Project-in-a-Box-JSOE/robotic_arm_arduino_uno_shield/Pot Holder/part#8Dimension.JPG

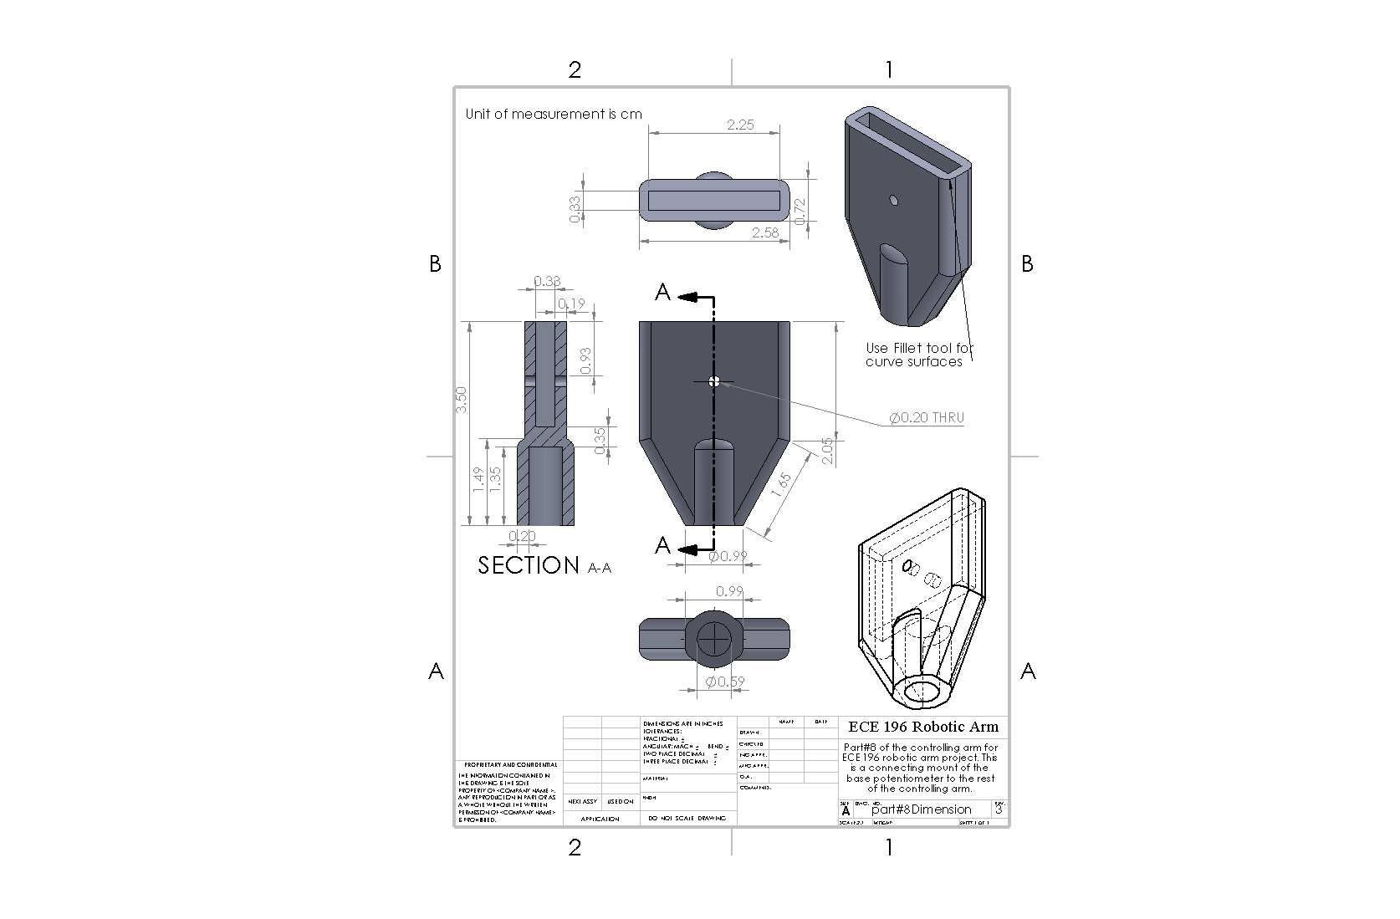
Pot Holder/part#8Dimension.JPG
