Project-in-a-Box-JSOE/robotic_arm_arduino_uno_shield/Robotic Arm PCB shield/robotic_arm_arduino_uno_shield_ece196_partList_new.csv

Qty | Value | Device | Package | Parts | Description | DATASHEET | DATASHEET_CABLE | DATASHEET_CONNECTOR | DIST | DISTLINK | DISTLINK_CABLE | DISTLINK_CONNECTOR | DISTLINK_CONNECTOR1 | DISTLINK_CONNECTOR2 | DISTPN | DISTPN_CABLE | DISTPN_CONNECTOR | DISTPN_CONNECTOR1 | DISTPN_CONNECTOR2 | DIST_CABLE | DIST_CONNECTOR | MFR | MFR_CABLE | MFR_CONNECTOR | MPN | MPN_CABLE | MPN_CONNECTOR | MPN_CONNECTOR1 | MPN_CONNECTOR2 | QTY_CONNECTOR1 | QTY_CONNECTOR2 | VALUE
4 | 0.1uF/35V | 0.1UF_SMD-0805_35V-10% | CAPC2012X95_SMD-0805 | C1, C2, C3, C4 |  | http://ds.yuden.co.jp/TYCOMPAS/ut/detail.do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 |  |  | Digikey | https://www.digikey.com/products/en?keywords=587-3364-1-ND |  |  |  |  | 587-3364-1-ND |  |  |  |  |  |  | Taiyo Yuden |  |  | GMK212BJ104KGHT |  |  |  |  |  |  | 0.1uF/35V
3 | 1000uF/16V | 1000UF-POLARIZED_PTH_16V-20% | _AE_PTH_DIA8-LS3.5-H21.50 | C0, C5, C6 |  | http://www.chemi-con.co.jp/cgi-bin/CAT_DB/SEARCH/cat_db_al.cgi?e=e&j=p&pdfname=kzm |  |  | Digikey | https://www.digikey.com/products/en?keywords=565-3567-ND |  |  |  |  | 565-3567-ND |  |  |  |  |  |  | United Chemi-Con |  |  | EKZM160ELL102MH20D |  |  |  |  |  |  | 1000uF/16V
3 | 10K | 10KΩ_SMD-0805_1/8W-5% | RESC2012X60_SMD-0805 | R0, R1, R2 |  | http://www.yageo.com/documents/recent/PYu-RC_Group_51_RoHS_L_9.pdf |  |  | Digikey | https://www.digikey.com/products/en?keywords=311-10KARCT-ND |  |  |  |  | 311-10KARCT-ND |  |  |  |  |  |  | Yageo |  |  | RC0805JR-0710KL |  |  |  |  |  |  | 10K
4 | 10K | POTENTIOMETER_CONNECTOR_PTH_VERT_FEMALE_2.54MM | HDRVR3W64P254_1X3_812X254X850B | POT1, POT2, POT3, POT4 |  | http://www.ttelectronics.com/sites/default/files/download-files/Datasheet_RotaryPanelPot_P160series.pdf |  | https://drawings-pdf.s3.amazonaws.com/10492.pdf | Digikey | https://www.digikey.com/products/en?keywords=987-1715-ND |  | https://www.digikey.com/products/en?keywords=PPTC031LFBN-RC |  |  | 987-1715-ND |  | S7001-ND |  |  |  | Digikey | TT Electronics/BI |  | Sullins Connector Solutions | P160KN2-0QA25B10K |  | PPTC031LFBN-RC |  |  |  |  | 10K
2 | 1A/50V | DIODE_GENERAL-PURPOSE_SMD_GP_1A-50V | SODFL3516X170 | D4, D5 |  | http://www.comchiptech.com/cms/UserFiles/CGRKM4001-HF%20Thru.%20CGRKM4007-HF%20RevG.pdf |  |  | Digikey | https://www.digikey.com/products/en?keywords=641-1511-1-ND |  |  |  |  | 641-1511-1-ND |  |  |  |  |  |  | Comchip Technology |  |  | CGRKM4001-HF |  |  |  |  |  |  | 1A/50V
2 | 1K | 1KΩ_SMD-0805_1/8W-5% | RESC2012X60_SMD-0805 | R3, R4 |  | http://www.yageo.com/documents/recent/PYu-RC_Group_51_RoHS_L_9.pdf |  |  | Digikey | https://www.digikey.com/products/en?keywords=311-1.0KARCT-ND |  |  |  |  | 311-1.0KARCT-ND |  |  |  |  |  |  | Yageo |  |  | RC0805JR-071KL |  |  |  |  |  |  | 1K
2 | 50mA/12V | SWITCH_MOMENTARY_SPST_PTH_L12-W12-H7.2 | BTN_MOMENTARY_SPST-NO_PTH_L12-W12 | S2, S3 |  | https://www.sparkfun.com/datasheets/Components/Buttons/TSA12110%20TACT%20SWITCH.jpg |  |  | Digikey | https://www.digikey.com/products/en?keywords=1568-1332-ND |  |  |  |  | 1568-1332-ND |  |  |  |  |  |  | SparkFun Electronics |  |  | COM-10302 |  |  |  |  |  |  | 50mA/12V
1 | 5A/28V | POWER_JACK-BARREL_ID2.1MM-OD5.5MM_PTH_ID2.1MM-OD5.5MM | POWER_JACK_PTH_ID2.1MM-OD5.5MM | J1 |  | https://www.cui.com/product/resource/pj-102a.pdf |  |  | Digikey | https://www.digikey.com/products/en?keywords=CP-102A-ND |  |  |  |  | CP-102A-ND |  |  |  |  |  |  | CUI Inc. |  |  | PJ-102A |  |  |  |  |  |  | 5A/28V
1 | 5A/28V | SWITCH_SPDT_VERT_PTH_5A-28V_13L-7W_ | SW_TOGGLE_SPDT_5A-28V_13L-7W | S1 |  | http://spec_sheets.e-switch.com/specs/T111597.pdf |  |  | Digikey | https://www.digikey.com/products/en?keywords=EG2355-ND |  |  |  |  | EG2355-ND |  |  |  |  |  |  | E-Switch |  |  | 100SP1T1B4M2QE |  |  |  |  |  |  | 5A/28V
1 | Arduino UNO R3 | ARDUINO_UNO_R3_NO-HOLES_NO-AVR-ISP_NO-I2C_NO-NC_NO-IOREF | ARDUINO_UNO_R3_NO-HOLES_NO-AVR-ISP_NO-I2C_NO-NC_NO-IOREF | ARDUINO1 |  | https://media.digikey.com/pdf/Data%20Sheets/Arduino%20PDFs/A000066_Web.pdf | http://www.assmann-wsw.com/fileadmin/datasheets/ASS_7066_CA.pdf | http://www.sullinscorp.com/drawings/77____C___S___N-OMIT,_M500,_STRAIGHT,_C10436.pdf | Digikey | https://www.digikey.com/products/en?keywords=1050-1024-ND | https://www.digikey.com/products/en?keywords=AE1462-ND |  | https://www.digikey.com/products/en?keywords=S1012E-06-ND | https://www.digikey.com/products/en?keywords=PEC08SAAN | 1050-1024-ND | AE1462-ND |  | S1012E-06-ND | S1012E-08-ND | Digikey | Digikey | Arduino | Assmann WSW Components | Sullins Connector Solutions | A000066 | AK672/2-1 |  | PEC06SAAN | PEC08SAAN | 2 | 2 | Arduino UNO R3
1 | BATTERY_LIPO_2S | BATTERY_LIPO_2S | DUAL_PTH_PADS | LIPO1
1 | BLUE | LED_SMD-0805_DISCRETE_BLUE | LEDC2012X120_LED-0805 | PWR_LED |  | http://optoelectronics.liteon.com/upload/download/DS-22-99-0226/LTST-C170TBKT.pdf |  |  | Digikey | https://www.digikey.com/products/en?keywords=160-1579-1-ND |  |  |  |  | 160-1579-1-ND |  |  |  |  |  |  | Lite-On Inc. |  |  | LTST-C170TBKT |  |  |  |  |  |  | BLUE
1 | GREEN | LED_SMD-0805_DISCRETE_GREEN | LEDC2012X120_LED-0805 | PLAY_LED |  | http://optoelectronics.liteon.com/upload/download/DS22-2000-073/LTST-C170KGKT.pdf |  |  | Digikey | https://www.digikey.com/products/en?keywords=160-1414-1-ND |  |  |  |  | 160-1414-1-ND |  |  |  |  |  |  | Lite-On Inc. |  |  | LTST-C170KGKT |  |  |  |  |  |  | GREEN
4 | MG90S | SERVO_MG90S_PTH_VERT_FEMALE_2.54MM | HDRVR3W64P254_1X3_812X254X850B | SERVO1, SERVO2, SERVO3, SERVO4 |  | N/A |  | https://drawings-pdf.s3.amazonaws.com/10492.pdf | Amazon | https://www.amazon.com/RioRand-MG90S-Metal-Geared-Helicopter/dp/B00M8SR0ZK?s=toys-and-games |  | https://www.digikey.com/products/en?keywords=PPTC031LFBN-RC |  |  | B00M8SR0ZK |  | S7001-ND |  |  |  | Digikey | TowerPro |  | Sullins Connector Solutions | MG90S |  | PPTC031LFBN-RC |  |  |  |  | MG90S
2 | MIC39100-5.0 5V/1A | MIC39100-XX_MIC39100-5.0_1A | SOT229P700X180-4 | VREG1, VREG2 |  | http://ww1.microchip.com/downloads/en/DeviceDoc/20005834A.pdf |  |  | Digikey | https://www.digikey.com/products/en?keywords=576-1173-ND |  |  |  |  | 576-1173-ND |  |  |  |  |  |  | Microchip Technology |  |  | MIC39100-5.0WS |  |  |  |  |  |  | MIC39100-5.0 5V/1A
1 | NET_BRIDGE | NET_BRIDGE | NET_BRIDGE | SUPPLY14
1 | RED | LED_SMD-0805_DISCRETE_RED | LEDC2012X120_LED-0805 | REC_LED |  | http://optoelectronics.liteon.com/upload/download/DS-22-99-0150/LTST-C170KRKT.pdf |  |  | Digikey | https://www.digikey.com/products/en?keywords=160-1415-1-ND |  |  |  |  | 160-1415-1-ND |  |  |  |  |  |  | Lite-On Inc. |  |  | LTST-C170KRKT |  |  |  |  |  |  | RED
