Project-in-a-Box-JSOE/robotic_arm_arduino_uno_shield/BaseServoMount/BaseServoMountAssem1.SLDASM

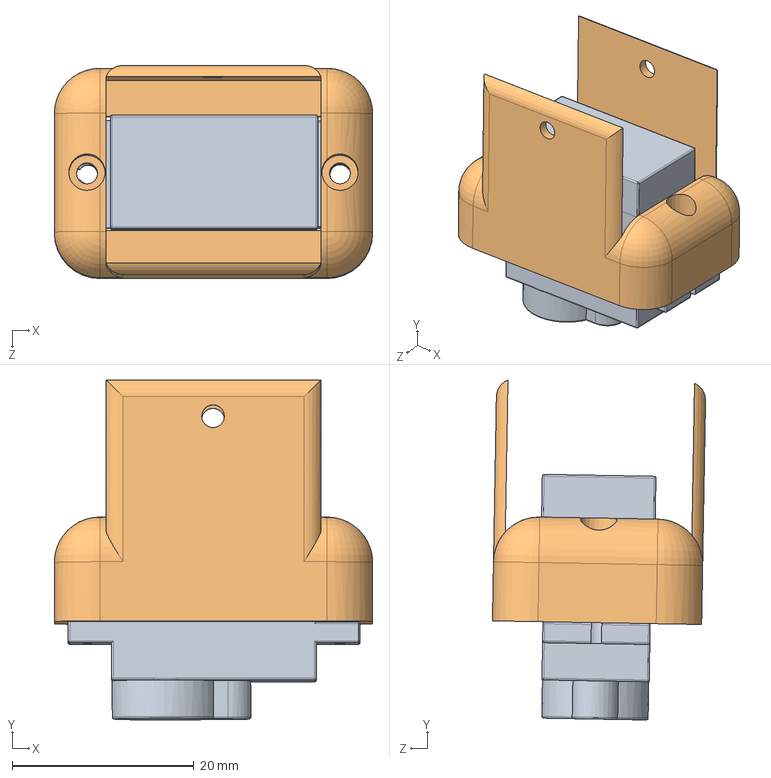
[picture p11: CAD file, 2018-07-06]
BaseServoMount/BaseServoMountAssem1.SLDASM
35.0 x 37.4 x 23.4 mm
BaseServoMount
