Project-in-a-Box-JSOE/robotic_arm_arduino_uno_shield/RoboticGripperV4/GripperAssemV1.SLDASM

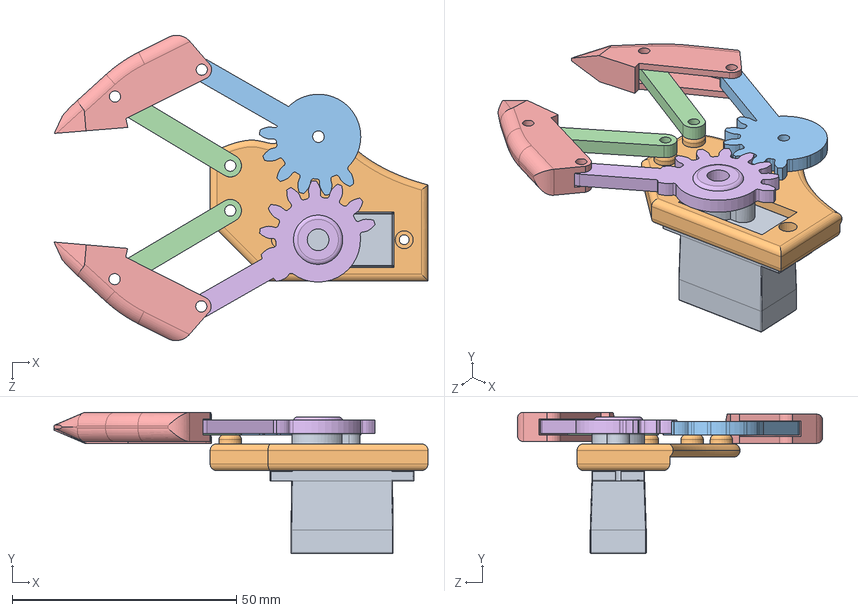
[picture p12: CAD file, 2018-07-06]
RoboticGripperV4/GripperAssemV1.SLDASM
83.4 x 31.5 x 68.1 mm
BaseV4Part1
RightGearPart2
ShortHandPart4 x 2
GripperHeadV4Part5 x 2
ServoGearPart3
