Project-in-a-Box-JSOE/robotic_arm_arduino_uno_shield/BaseServoMount/BaseServoMount.SLDPRT

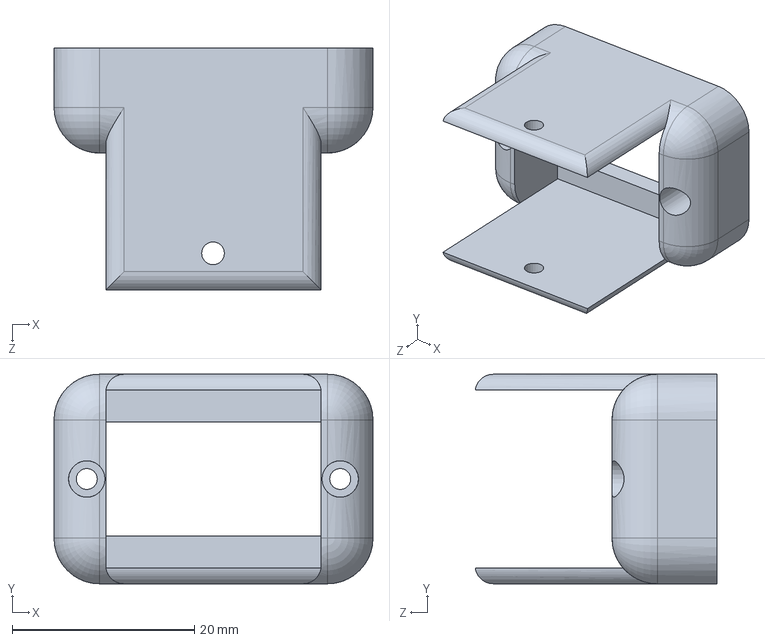
[picture p13: CAD file, 2018-07-06]
BaseServoMount/BaseServoMount.SLDPRT
35.0 x 23.0 x 26.5 mm
