Project-in-a-Box-JSOE/robotic_arm_arduino_uno_shield/Pot Holder/potHolderV5.STL

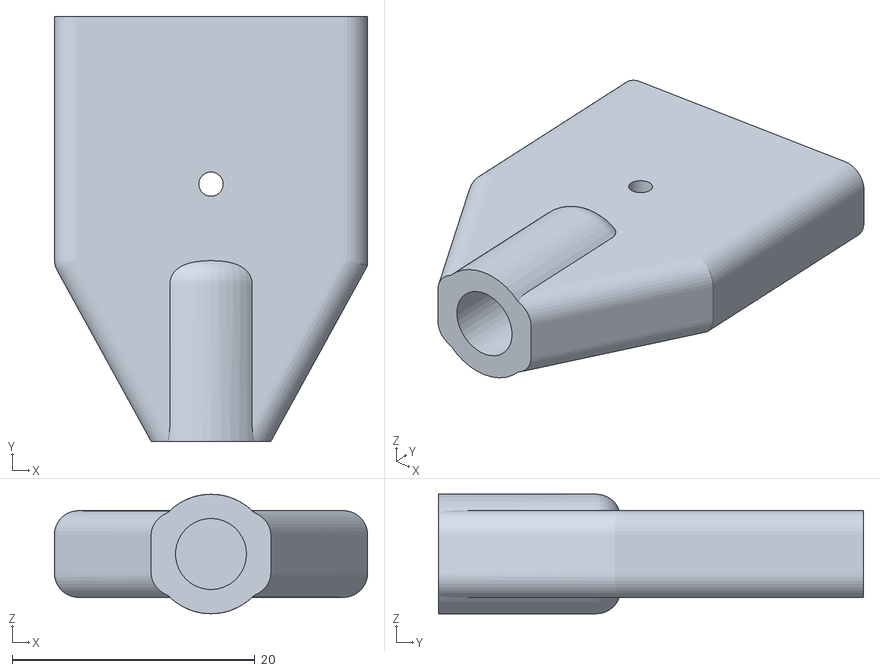
[picture p14: CAD file, 2018-07-06]
Pot Holder/potHolderV5.STL
25.8 x 35.0 x 9.85
