Project-in-a-Box-JSOE/robotic_arm_arduino_uno_shield/RoboticGripperV4/GripperHeadV4Part5.SLDPRT

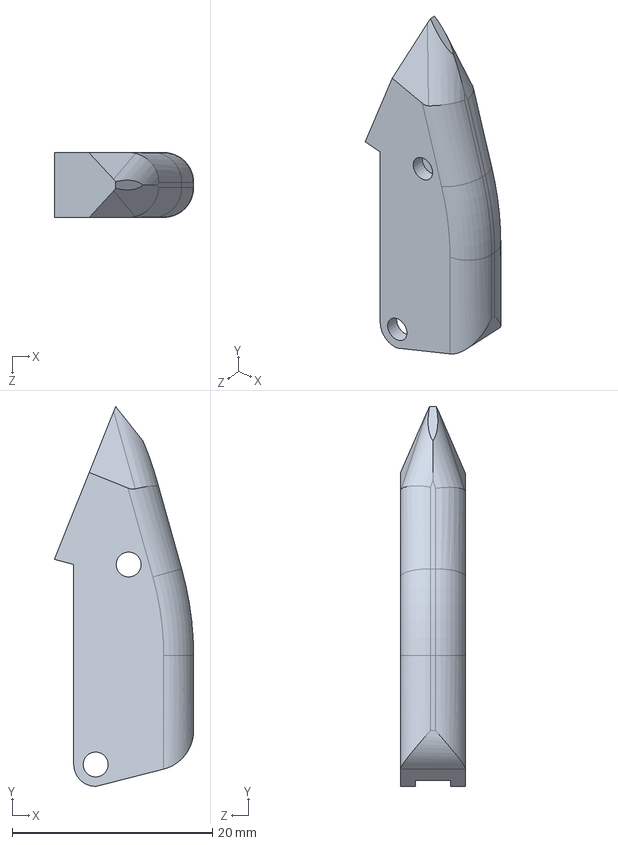
[picture p15: CAD file, 2018-07-06]
RoboticGripperV4/GripperHeadV4Part5.SLDPRT
13.9 x 38.0 x 6.50 mm
