Project-in-a-Box-JSOE/robotic_arm_arduino_uno_shield/RoboticGripperV4/ShortHandPart4.SLDPRT

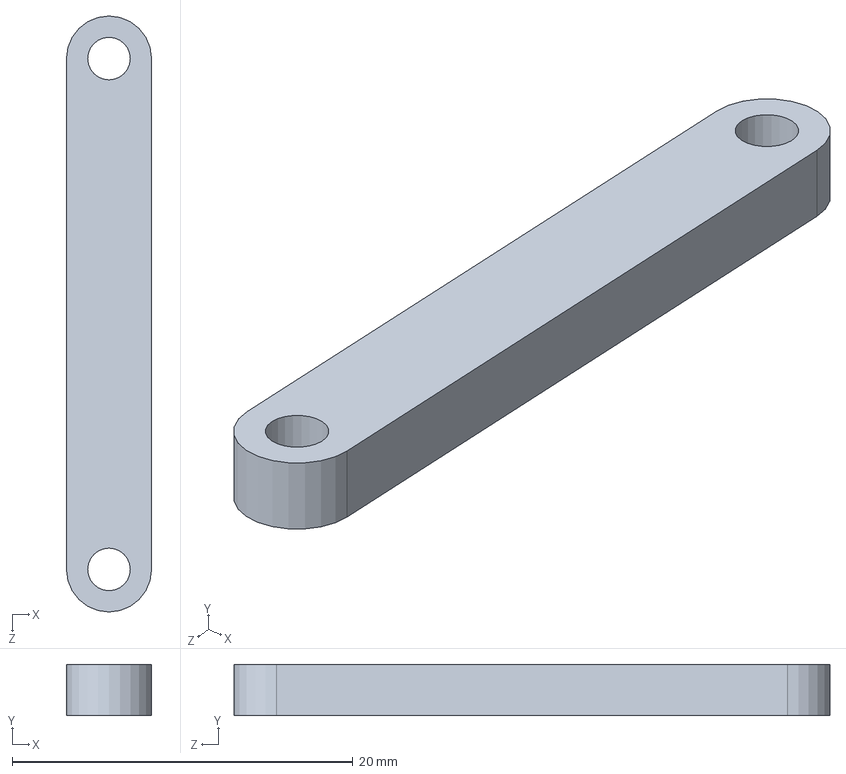
[picture p16: CAD file, 2018-07-06]
RoboticGripperV4/ShortHandPart4.SLDPRT
5.00 x 3.00 x 35.0 mm
