Project-in-a-Box-JSOE/robotic_arm_arduino_uno_shield/RoboticGripperV4/Part1.SLDPRT

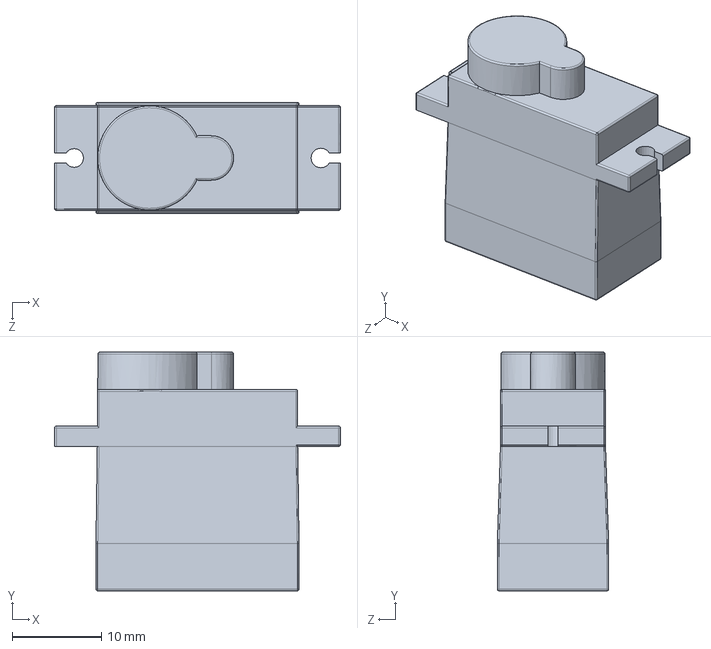
[picture p17: CAD file, 2018-07-06]
RoboticGripperV4/Part1.SLDPRT
32.1 x 26.8 x 12.5 mm
