Project-in-a-Box-JSOE/robotic_arm_arduino_uno_shield/RoboticGripperV4/BaseV4Part1.SLDPRT

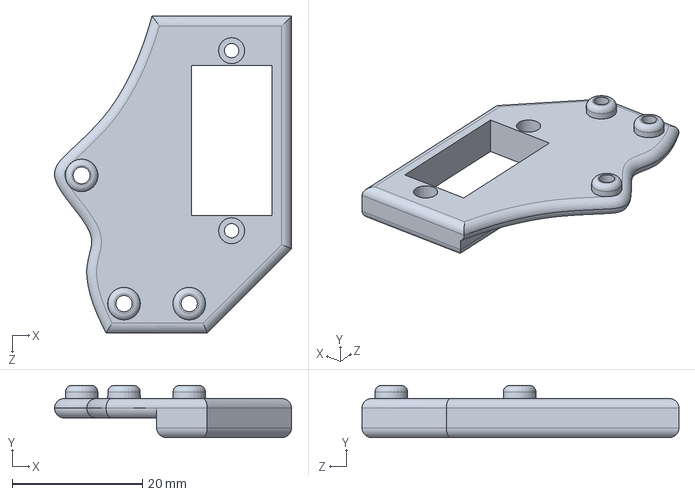
[picture p18: CAD file, 2018-07-06]
RoboticGripperV4/BaseV4Part1.SLDPRT
36.3 x 8.00 x 48.6 mm
