Project-in-a-Box-JSOE/robotic_arm_arduino_uno_shield/RoboticGripperV4/RightGearPart2.SLDPRT

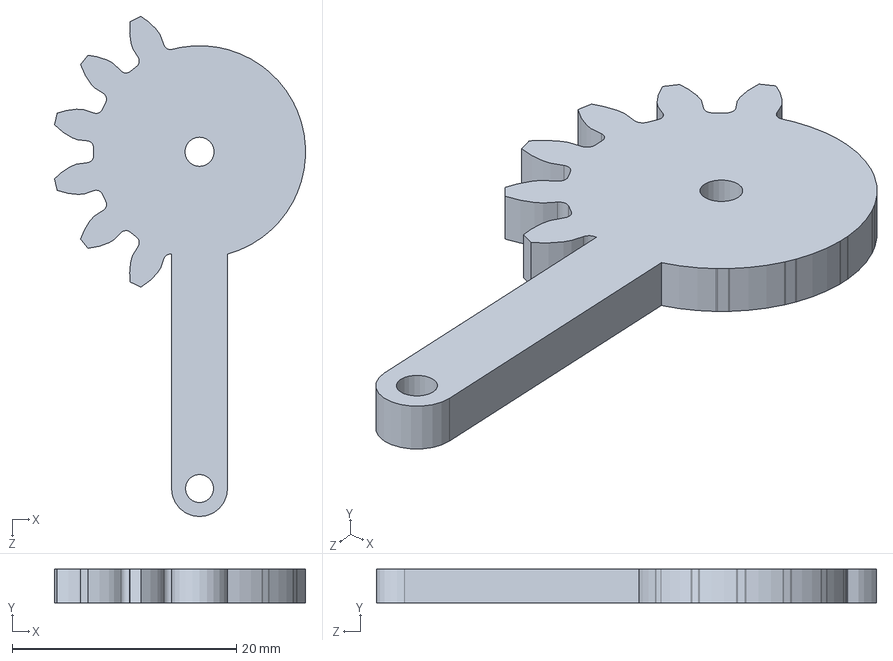
[picture p19: CAD file, 2018-07-06]
RoboticGripperV4/RightGearPart2.SLDPRT
22.4 x 3.00 x 44.6 mm
