Project-in-a-Box-JSOE/robotic_arm_arduino_uno_shield/RoboticGripperV4/GripperHeadV5Part5.SLDPRT

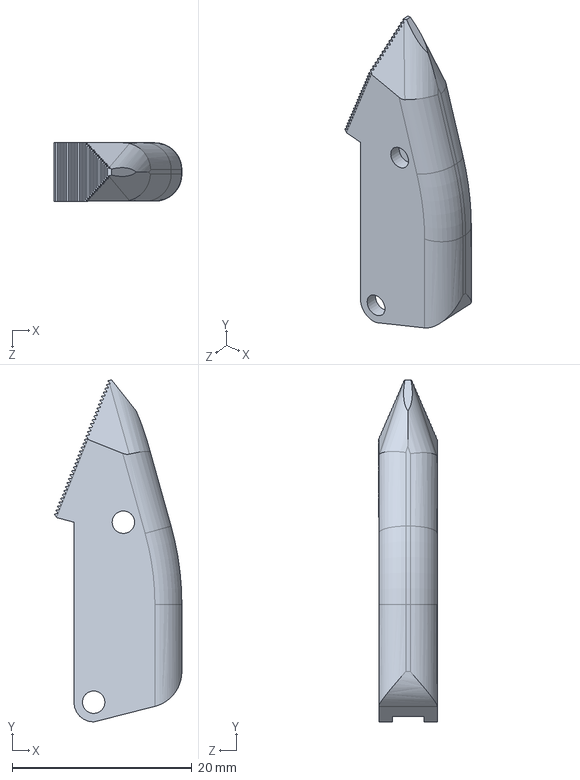
[picture p20: CAD file, 2018-07-06]
RoboticGripperV4/GripperHeadV5Part5.SLDPRT
14.2 x 38.0 x 6.50 mm
