Project-in-a-Box-JSOE/robotic_arm_arduino_uno_shield/RoboticGripperV4/ServoGearPart3.SLDPRT

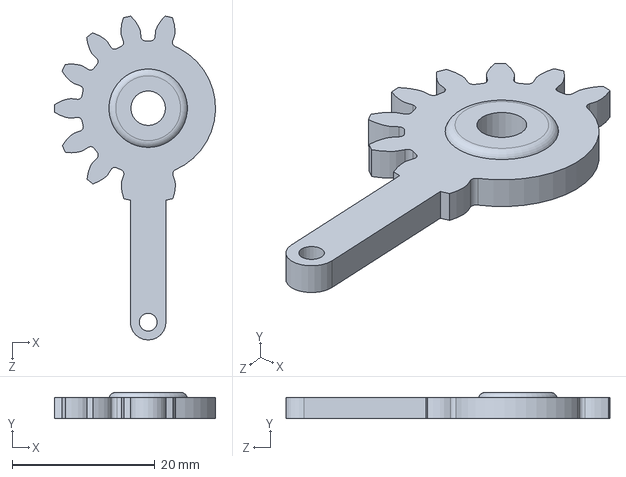
[picture p21: CAD file, 2018-07-06]
RoboticGripperV4/ServoGearPart3.SLDPRT
22.6 x 3.70 x 45.4 mm
