Project-in-a-Box-JSOE/robotic_arm_arduino_uno_shield/(list of files, cad)

Other CAD files:
BaseServoMount/part#11.STL
Pot Holder/part#8.SLDPRT
Pot Holder/potHolder.SLDPRT
Pot Holder/potHolderV4.STL
Pot Holder/part#8Dimension.SLDDRW
RoboticGripperV4/BaseV4Part1.STL
RoboticGripperV4/GripperHeadV4Part5.STL
RoboticGripperV4/GripperHeadV5Part5.STL
RoboticGripperV4/RightGearPart2.STL
RoboticGripperV4/ServoGearPart3.STL
RoboticGripperV4/ShortHandPart4.STL
