Project-in-a-Box-JSOE/robotic_arm_arduino_uno_shield/Robotic Arm PCB shield/robotic_arm_arduino_uno_shield_ece196.brd

## EAGLE design Robotic Arm PCB shield/robotic_arm_arduino_uno_shield_ece196.brd (2018-09-04)

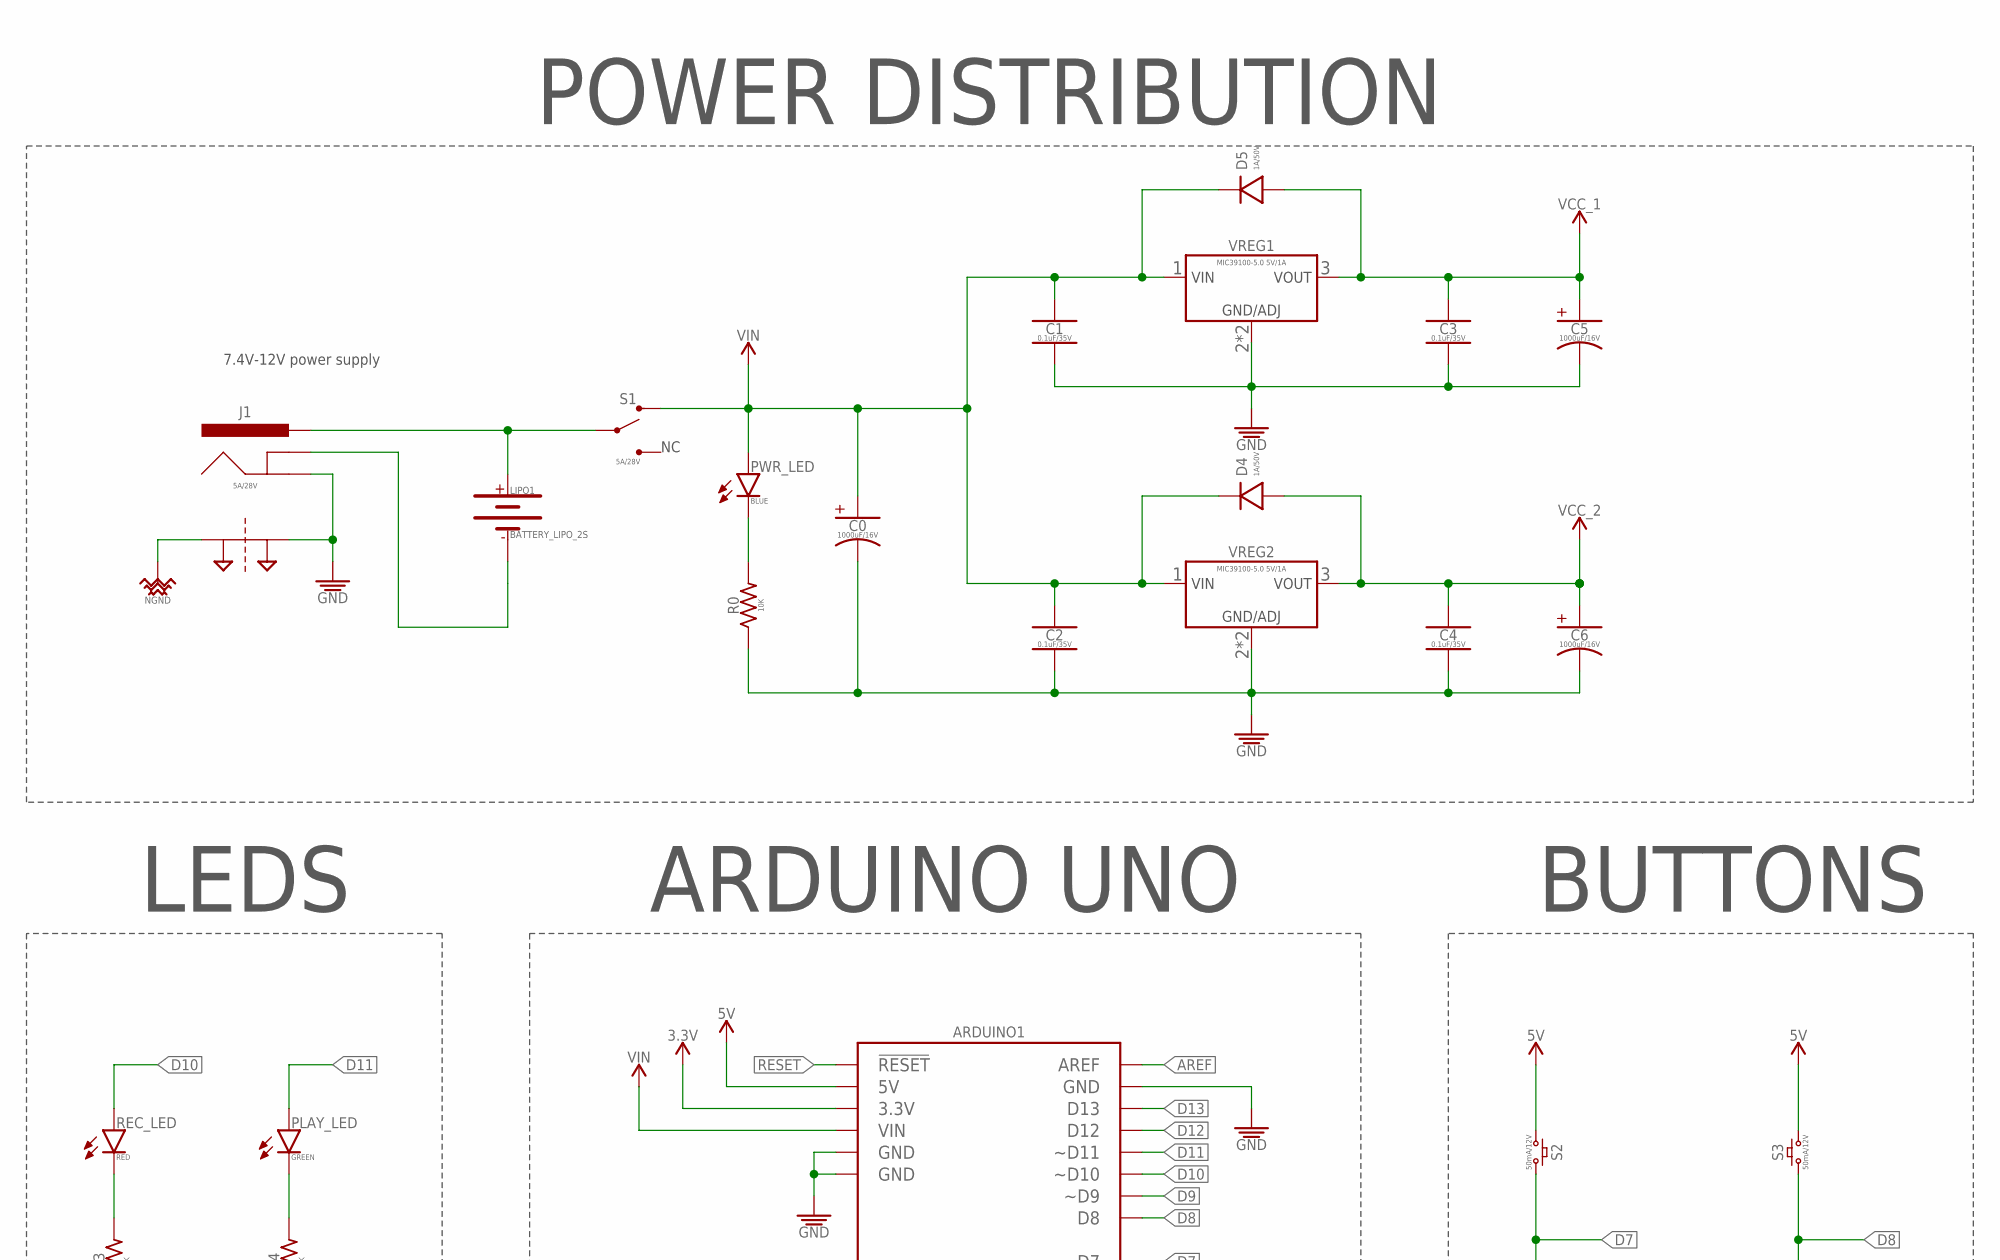
[picture p45: schematic robotic_arm_arduino_uno_shield_ece196.sch, part in row 1, column 1]

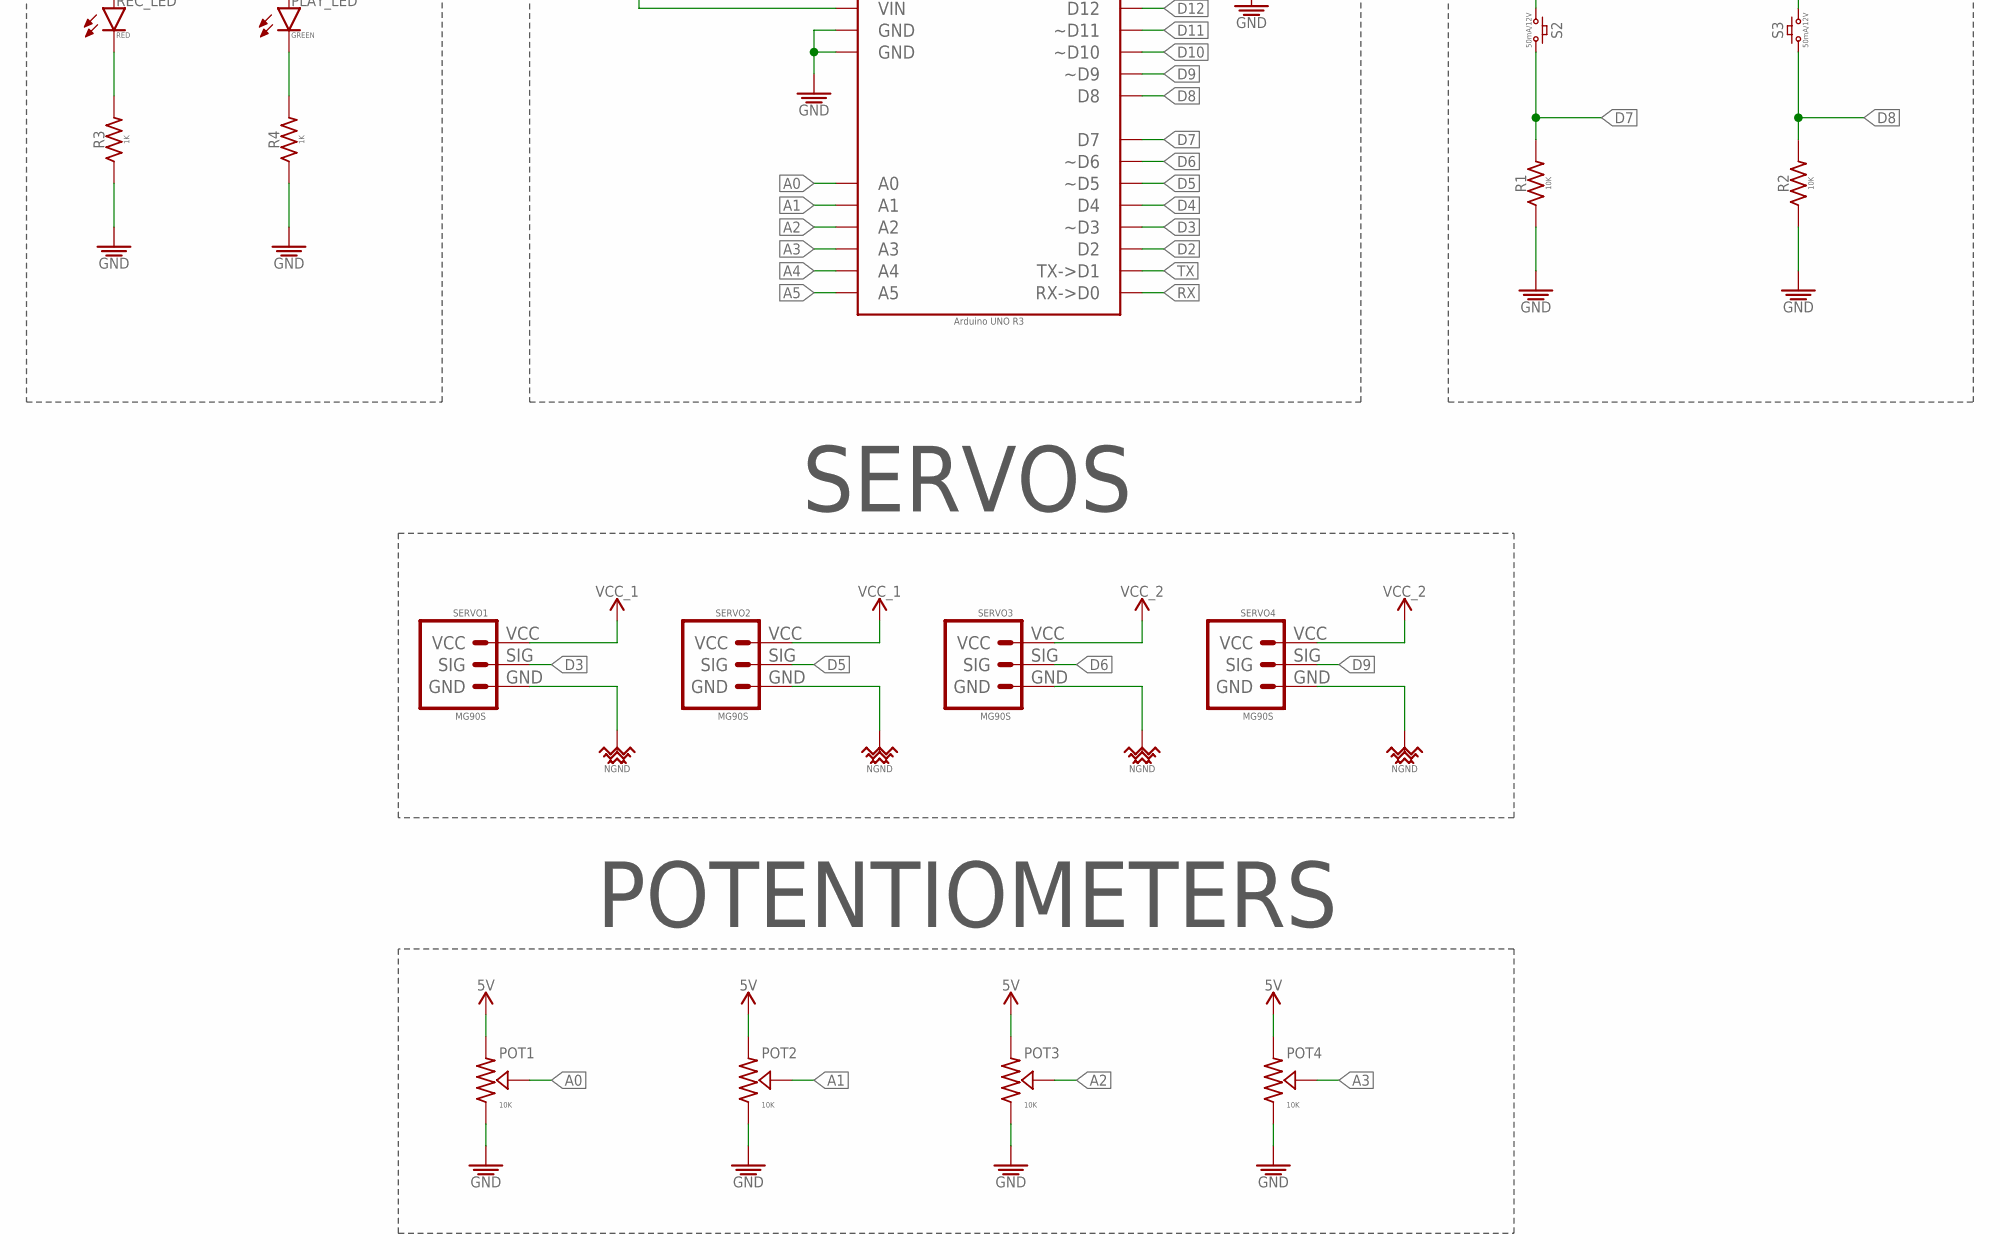
[picture p46: schematic robotic_arm_arduino_uno_shield_ece196.sch, part in row 2, column 1]

Parts:
ARDUINO1: Arduino UNO R3; ARDUINO_UNO_R3_NO-HOLES_NO-AVR-ISP_NO-I2C_NO-NC_NO-IOREF
C0, C5, C6: 1000uF/16V; _AE_PTH_DIA8-LS3.5-H21.50
C1, C2, C3, C4: 0.1uF/35V; CAPC2012X95_SMD-0805
D4, D5: 1A/50V; SODFL3516X170
J1: 5A/28V; POWER_JACK_PTH_ID2.1MM-OD5.5MM
LIPO1: BATTERY_LIPO_2S; DUAL_PTH_PADS
PLAY_LED: GREEN; LEDC2012X120_LED-0805
POT1, POT2, POT3, POT4: 10K; HDRVR3W64P254_1X3_812X254X850B
PWR_LED: BLUE; LEDC2012X120_LED-0805
R0, R1, R2: 10K; RESC2012X60_SMD-0805
R3, R4: 1K; RESC2012X60_SMD-0805
REC_LED: RED; LEDC2012X120_LED-0805
S1: 5A/28V; SW_TOGGLE_SPDT_5A-28V_13L-7W
S2, S3: 50mA/12V; BTN_MOMENTARY_SPST-NO_PTH_L12-W12
SERVO1, SERVO2, SERVO3, SERVO4: MG90S; HDRVR3W64P254_1X3_812X254X850B
SUPPLY14: NET_BRIDGE
VREG1, VREG2: MIC39100-5.0 5V/1A; SOT229P700X180-4

Connections:
3.3V: ARDUINO1.3.3V
5V: ARDUINO1.5V, POT1.CCW, POT2.CCW, POT3.CCW, POT4.CCW, S2.1, S3.3 (2)
+: J1.PWR, LIPO1.+, S1.P
-: J1.GND_BATTERY, LIPO1.-
A0: ARDUINO1.A0, POT1.S
A1: ARDUINO1.A1, POT2.S
A2: ARDUINO1.A2, POT3.S
A3: ARDUINO1.A3, POT4.S
A4: ARDUINO1.A4
A5: ARDUINO1.A5
AREF: ARDUINO1.AREF
D2: ARDUINO1.D2
D3: ARDUINO1.D3 (~D3), SERVO1.SIG
D4: ARDUINO1.D4
D5: ARDUINO1.D5 (~D5), SERVO2.SIG
D6: ARDUINO1.D6 (~D6), SERVO3.SIG
D7: ARDUINO1.D7, R1.2, S2.3 (2)
D8: ARDUINO1.D8, R2.2, S3.1
D9: ARDUINO1.D9 (~D9), SERVO4.SIG
D10: ARDUINO1.D10 (~D10), REC_LED.A
D11: ARDUINO1.D11 (~D11), PLAY_LED.A
D12: ARDUINO1.D12
D13: ARDUINO1.D13
GND: ARDUINO1.GND@1 (GND), ARDUINO1.GND@2 (GND), ARDUINO1.GND@3 (GND), C0.- (K), C1.2, C2.2, C3.2, C4.2, C5.- (K), C6.- (K), J1.GND_JACK, POT1.CW, POT2.CW, POT3.CW, POT4.CW, R0.1, R1.1, R2.1, R3.1, R4.1, SUPPLY14.P$2, VREG1.2 (GND), VREG1.TAB (GND), VREG2.2 (GND), VREG2.TAB (GND)
unnamed: PLAY_LED.K, R4.2
unnamed: R3.2, REC_LED.K
unnamed: PWR_LED.K, R0.2
NGND: SERVO1.GND, SERVO2.GND, SERVO3.GND, SERVO4.GND, SUPPLY14.P$1
RESET: ARDUINO1.RESET@1 (!RESET!)
RX: ARDUINO1.D0 (RX->D0)
TX: ARDUINO1.D1 (TX->D1)
VCC_1: C3.1, C5.+ (A), D5.A, SERVO1.VCC, SERVO2.VCC, VREG1.3 (VO)
VCC_2: C4.1, C6.+ (A), D4.A, SERVO3.VCC, SERVO4.VCC, VREG2.3 (VO)
VIN: ARDUINO1.VIN, C0.+ (A), C1.1, C2.1, D4.K, D5.K, PWR_LED.A, S1.S1, VREG1.1 (VI), VREG2.1 (VI)

Notes on the sheet:
7.4V-12V power supply
SERVOS
LEDS
BUTTONS
ARDUINO UNO
POTENTIOMETERS
POWER DISTRIBUTION

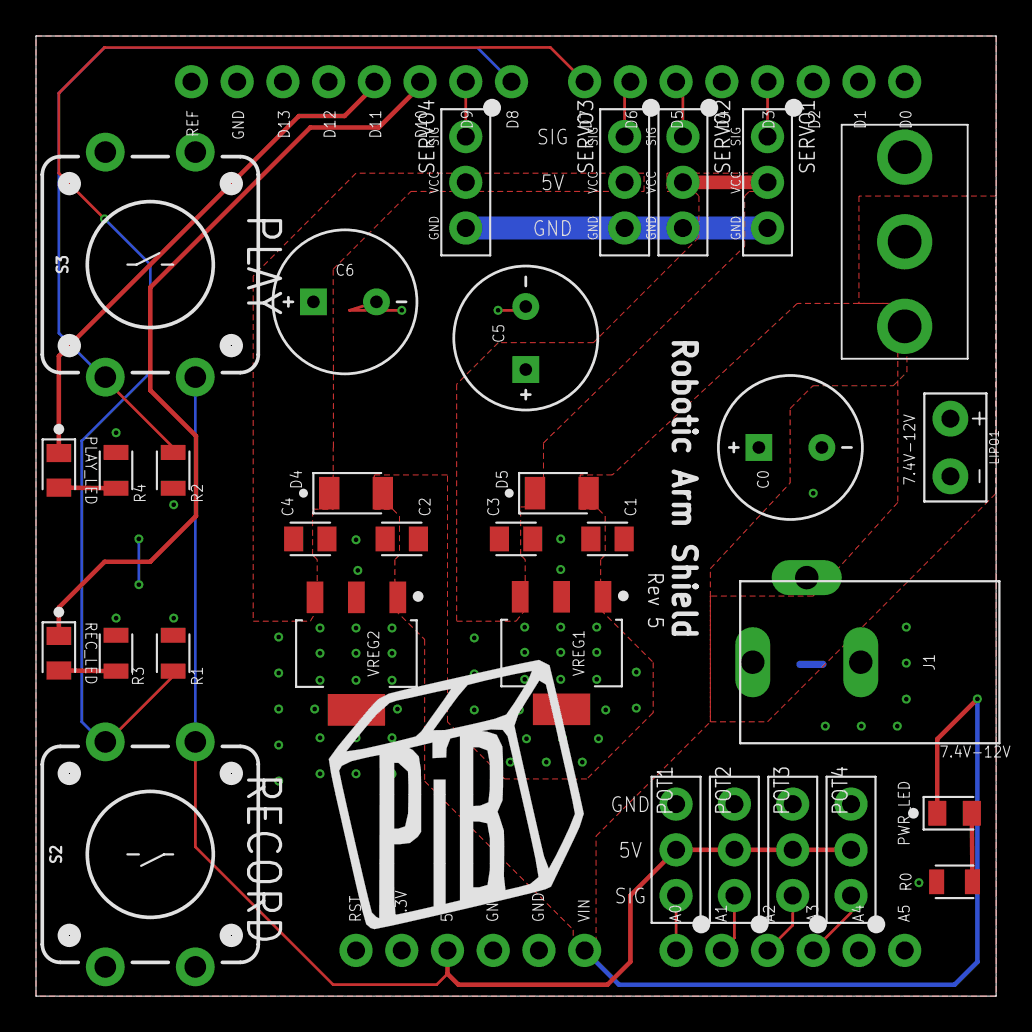
[picture p47: board robotic_arm_arduino_uno_shield_ece196.brd from above]

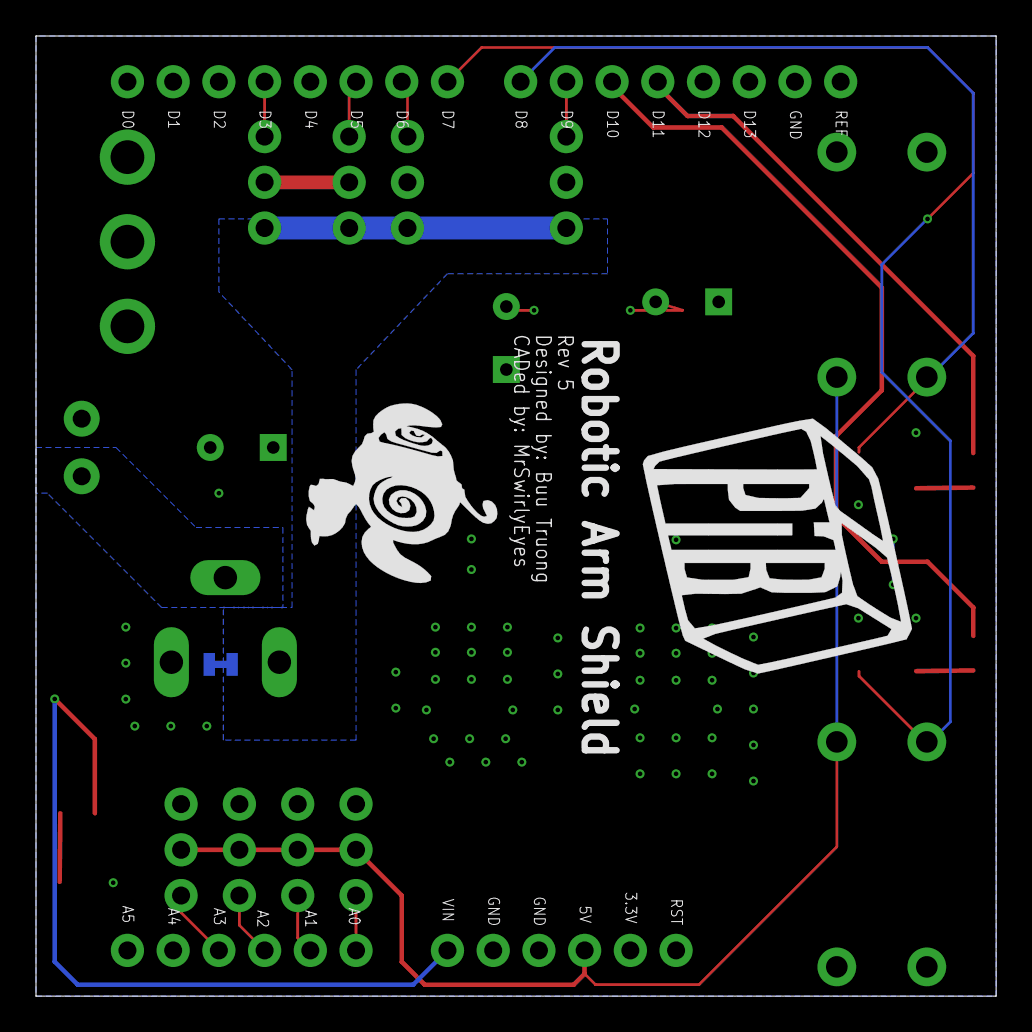
[picture p48: board robotic_arm_arduino_uno_shield_ece196.brd from below]

Board: 2 copper layers, 53.3 x 53.3 mm, 37 parts (3 on the bottom side), 23 nets.

Other parts of the board:
U$2: MRSWIRLYEYES-LOGO
U$3, U$4: PIB_LOGO_5MM
