Project-in-a-Box-JSOE/robotic_arm_arduino_uno_shield/Robotic Arm PCB shield/robotic_arm_arduino_uno_shield_new.brd

## EAGLE design Robotic Arm PCB shield/robotic_arm_arduino_uno_shield_new.brd (2017-09-14)

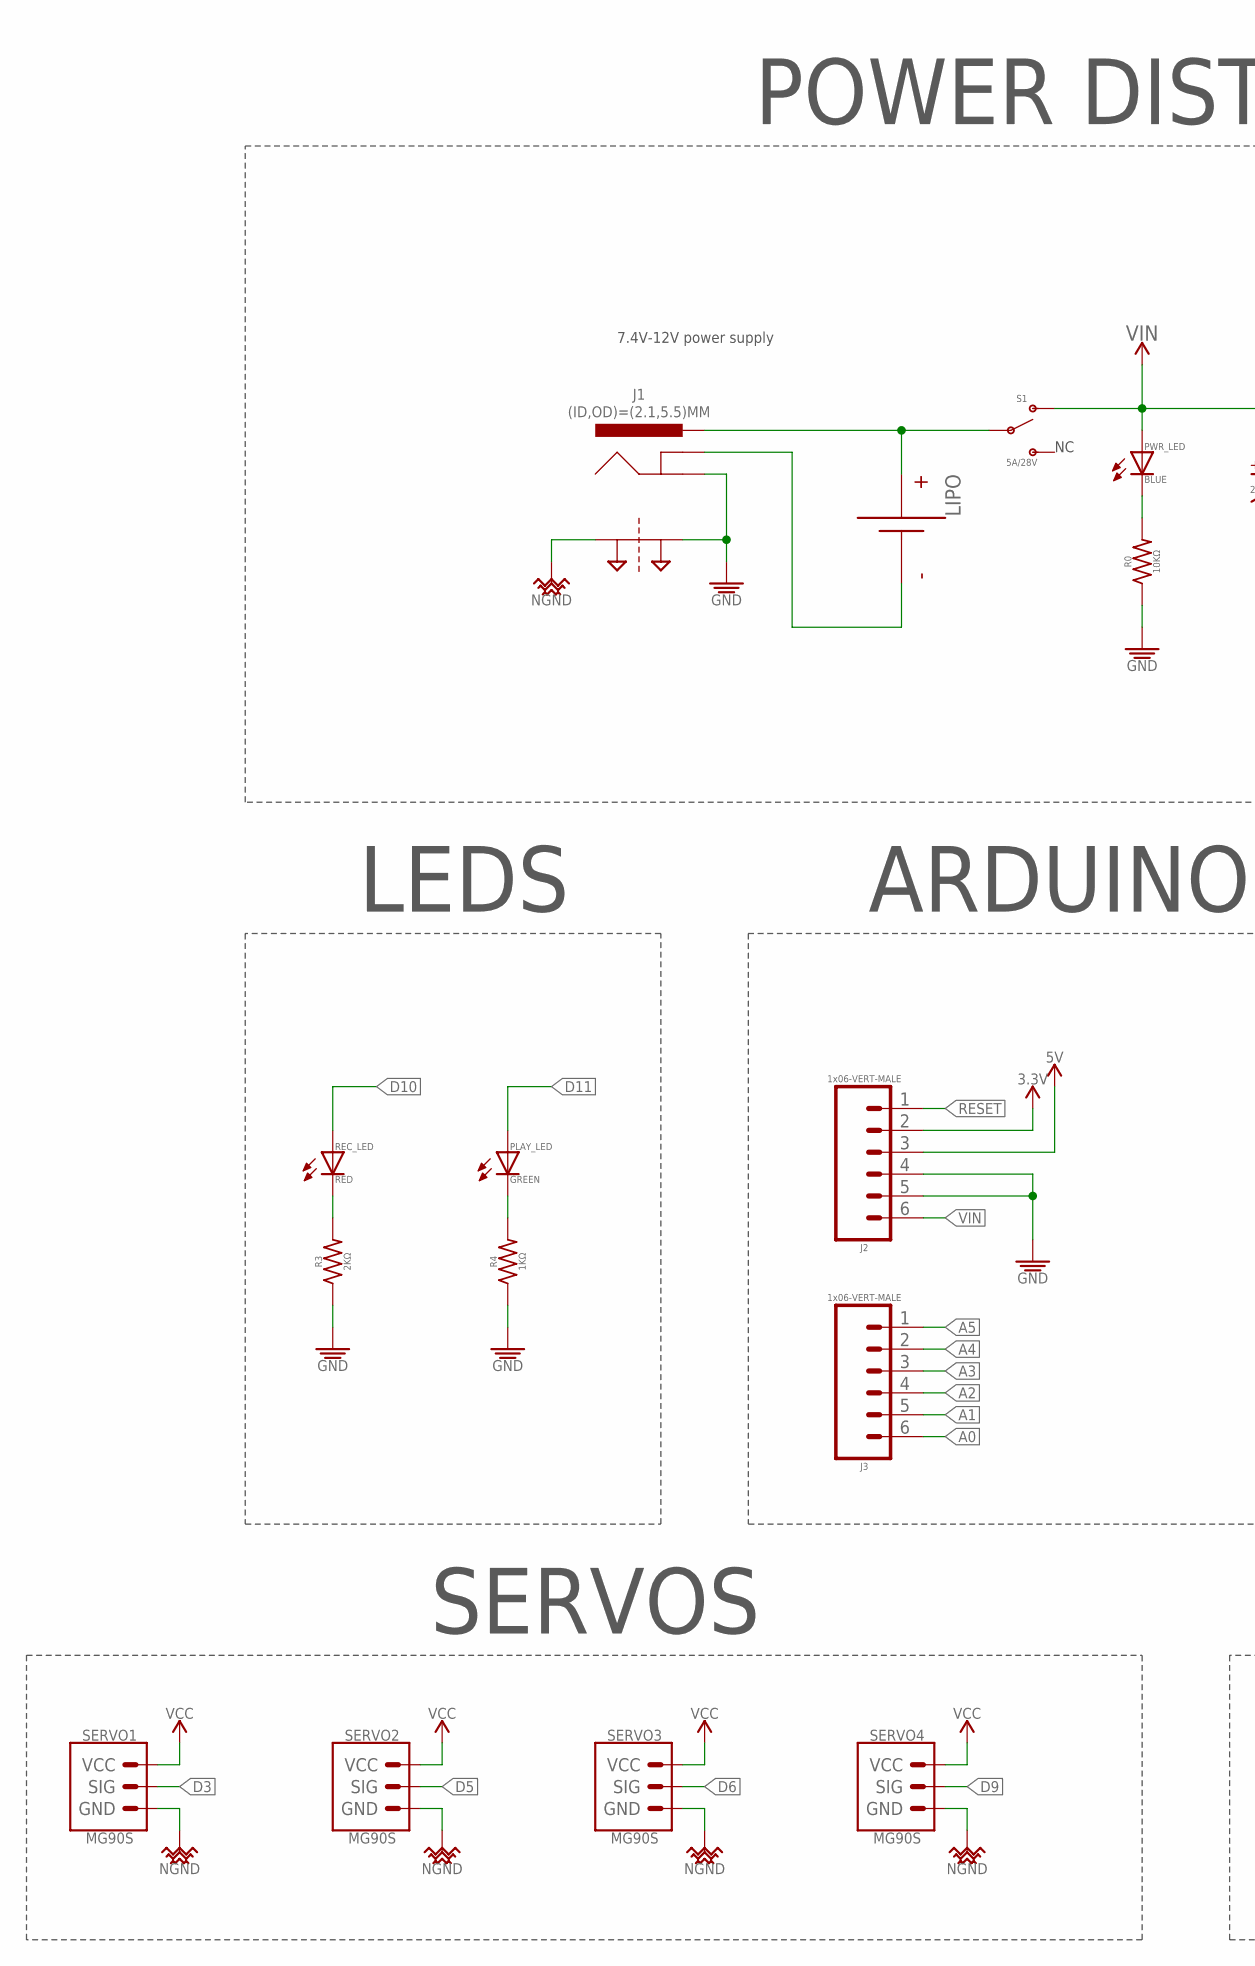
[picture p49: schematic robotic_arm_arduino_uno_shield_new.sch, part in row 1, column 1]

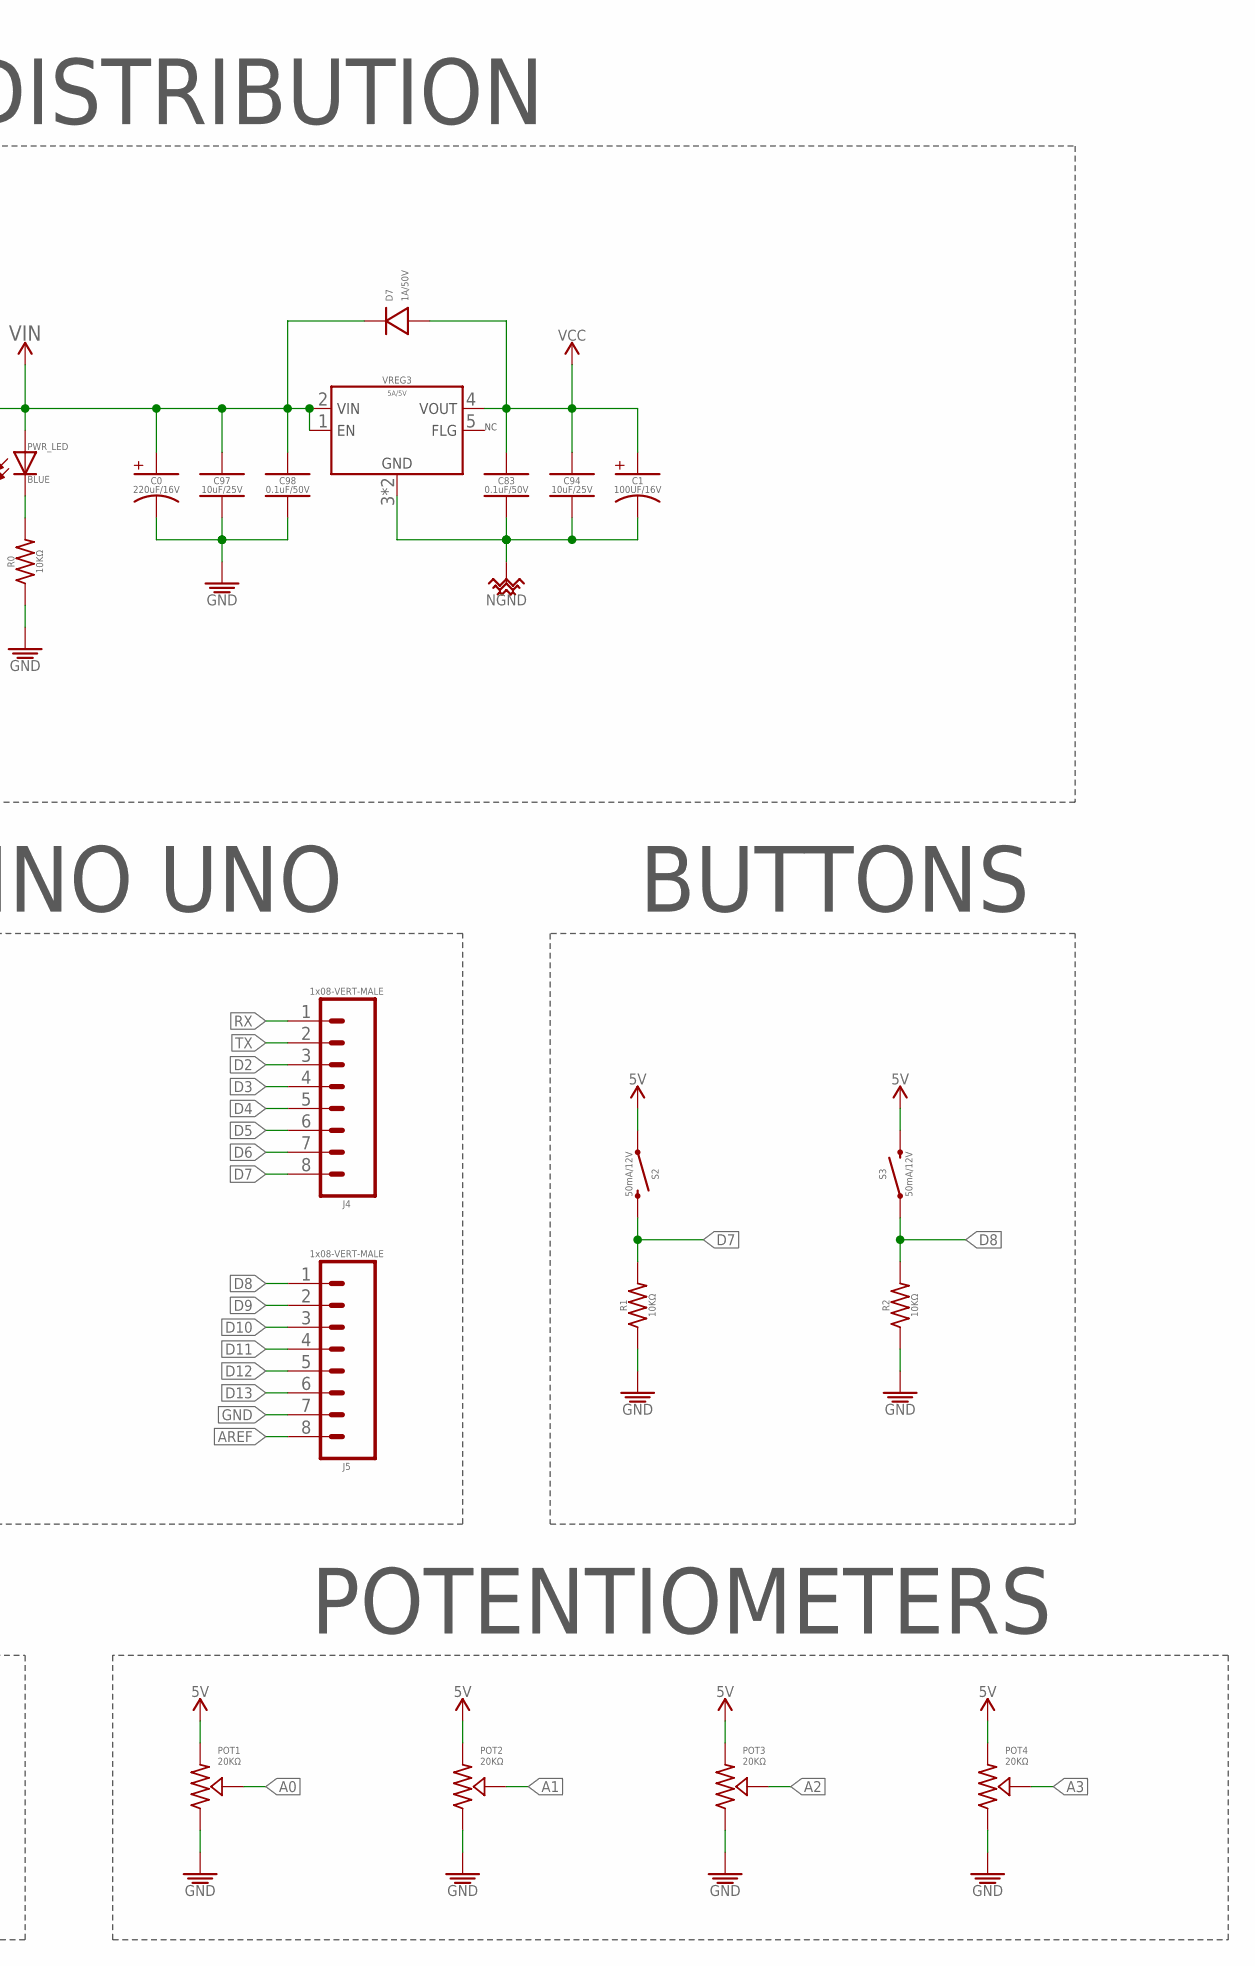
[picture p50: schematic robotic_arm_arduino_uno_shield_new.sch, part in row 1, column 2]

Parts:
C0: 220uF/16V; CAP_POL_SMD_L6.6-W6.6
C1: 100UF/16V; CAP_POL_SMD_L6.6-W6.6
C83, C98: 0.1uF/50V; CAP_CER_SMD-805
C94, C97: 10uF/25V; CAP_CER_SMD-805
D7: 1A/50V; DIODE_SMD_1A-50V-SOD123F
J1: (ID,OD)=(2.1,5.5)MM; POWER_JACK_SLOT_ID2.1MM-OD5.5MM
J2, J3: 1x06-VERT-MALE; 1X06-VERT-MALE
J4, J5: 1x08-VERT-MALE; 1X08-VERT-MALE
LIPO: BATTERYPTH_HOLES; DUAL_PTH_PADS
PLAY_LED: GREEN; LED_SMD-805_
POT1, POT2, POT3, POT4: 20KΩ; CONNECTOR_POTENTIOMETER_NO-MARKINGS_FEMALE-HEADER
PWR_LED: BLUE; LED_SMD-805_
R0, R1, R2: 10KΩ; RESISTOR_SMD-805
R3: 2KΩ; RESISTOR_SMD-805
R4: 1KΩ; RESISTOR_SMD-805
REC_LED: RED; LED_SMD-805_
S1: 5A/28V; SW-SLIDE_SPDT_5A-28V_13L-7W
S2, S3: 50mA/12V; SPST-PTH-12MM
SERVO1, SERVO2, SERVO3, SERVO4: MG90S; CONNECTOR_SERVO_NO-MARKINGS
SUPPLY14: 2PT_GND_TIE
VREG3: 5A/5V; TO-263-5

Connections:
3.3V: J2.2
5V: J2.3, POT1.CCW, POT2.CCW, POT3.CCW, POT4.CCW, S2.1, S3.3 (2)
+: J1.PWR, LIPO.+, S1.P$2
-: J1.GND@2 (GND), LIPO.- (N)
A0: J3.6, POT1.S
A1: J3.5, POT2.S
A2: J3.4, POT3.S
A3: J3.3, POT4.S
A4: J3.2
A5: J3.1
AREF: J5.8
D2: J4.3
D3: J4.4, SERVO1.1 (SIG)
D4: J4.5
D5: J4.6, SERVO2.1 (SIG)
D6: J4.7, SERVO3.1 (SIG)
D7: J4.8, R1.2, S2.3 (2)
D8: J5.1, R2.2, S3.1
D9: J5.2, SERVO4.1 (SIG)
D10: J5.3, REC_LED.A
D11: J5.4, PLAY_LED.A
D12: J5.5
D13: J5.6
GND: C0.K, C97.2, C98.2, J1.GND@1 (GND), J2.4, J2.5, J5.7, POT1.CW, POT2.CW, POT3.CW, POT4.CW, R0.1, R1.1, R2.1, R3.1, R4.1, SUPPLY14.P$2
unnamed: PLAY_LED.K, R4.2
unnamed: R3.2, REC_LED.K
unnamed: PWR_LED.K, R0.2
NGND: C1.K, C83.2, C94.2, SERVO1.3 (GND), SERVO2.3 (GND), SERVO3.3 (GND), SERVO4.3 (GND), SUPPLY14.P$1, VREG3.3 (GND), VREG3.TAB (GND)
RESET: J2.1
RX: J4.1
TX: J4.2
VCC: C1.A, C83.1, C94.1, D7.A, SERVO1.2 (VCC), SERVO2.2 (VCC), SERVO3.2 (VCC), SERVO4.2 (VCC), VREG3.4 (VOUT)
VIN: C0.A, C97.1, C98.1, D7.K, J2.6, PWR_LED.A, S1.P$1 (S1), VREG3.1 (EN), VREG3.2 (VIN)

Notes on the sheet:
7.4V-12V power supply
SERVOS
LEDS
BUTTONS
ARDUINO UNO
POTENTIOMETERS
POWER DISTRIBUTION

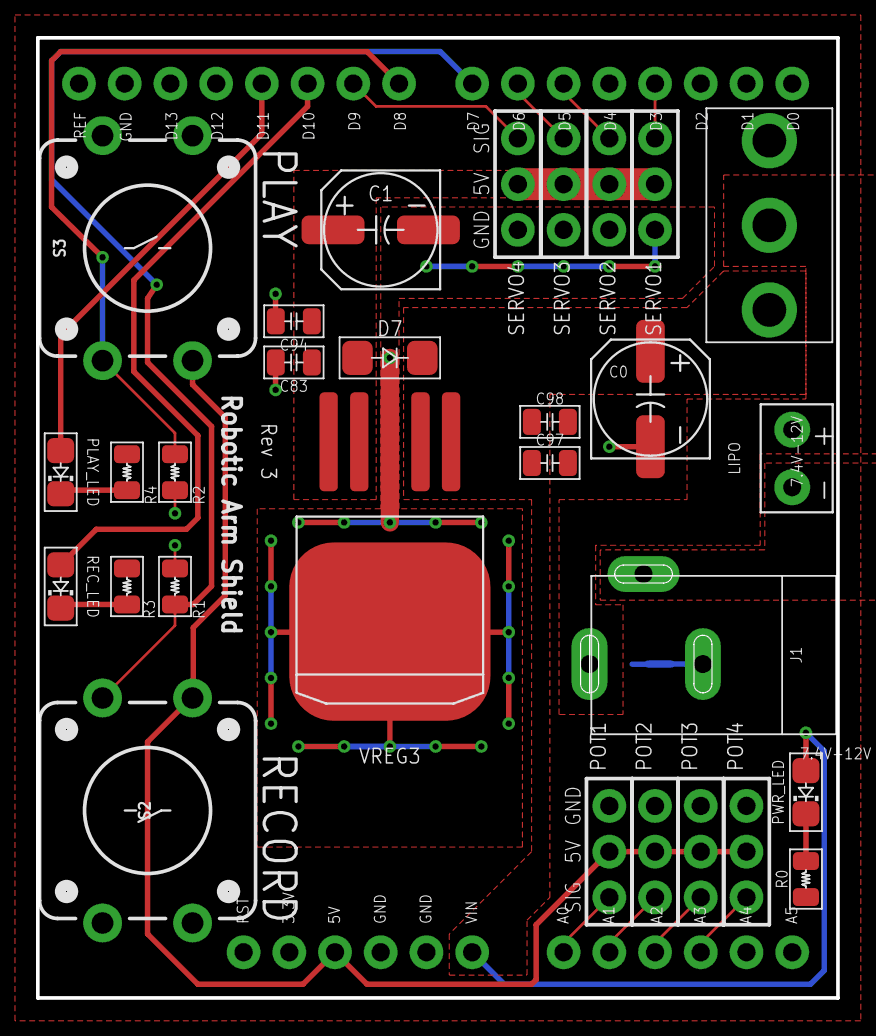
[picture p51: board robotic_arm_arduino_uno_shield_new.brd from above]

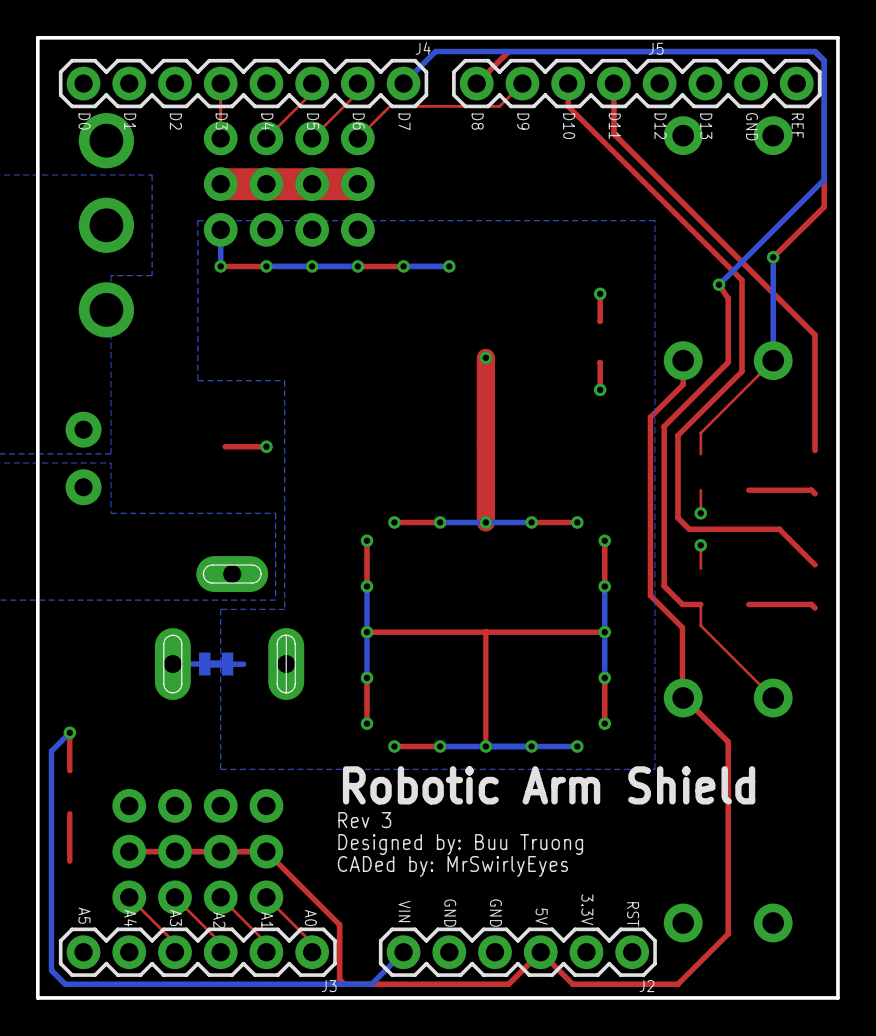
[picture p52: board robotic_arm_arduino_uno_shield_new.brd from below]

Board: 2 copper layers, 44.5 x 53.3 mm, 34 parts (5 on the bottom side), 22 nets.
