Project-in-a-Box-JSOE/robotic_arm_arduino_uno_shield/(commit log)

2017-08-01 Added Buus Robotic Arm Arduino Uno Shield
    [robotic_arm_arduino_uno_shield_smd.brd, robotic_arm_arduino_uno_shield_smd.sch]
2017-08-01 Adjusted some of the traces
    [robotic_arm_arduino_uno_shield_smd.brd, robotic_arm_arduino_uno_shield_smd.sch]
2017-08-01 Adjusted last VIN trace
    [robotic_arm_arduino_uno_shield_smd.brd]
2017-08-02 Final version. Sending to fab
    [robotic_arm_arduino_uno_shield_smd.brd, robotic_arm_arduino_uno_shield_smd.sch]
2017-08-02 Changed out switch. Adjusted traces accordingly
    [robotic_arm_arduino_uno_shield_smd.brd, robotic_arm_arduino_uno_shield_smd.sch]
2017-08-02 Small adjusted traces before fab
    [robotic_arm_arduino_uno_shield_smd.brd]
2017-08-29 Rev 2. Changed pad sizes of 805 SMD components.
    [robotic_arm_arduino_uno_shield_smd.brd, robotic_arm_arduino_uno_shield_smd.sch]
2017-09-01 Added switch object parameters for power switch and PLAY,RECORD buttons. Added potentiometer from digikey to POT object. Added Servo from Amazon to SERVO object MG90S
    [robotic_arm_arduino_uno_shield_smd.brd, robotic_arm_arduino_uno_shield_smd.sch]
2017-09-01 Rev 2. Modified board and schematic for new parts
    [robotic_arm_arduino_uno_shield_smd.brd, robotic_arm_arduino_uno_shield_smd.sch]
2017-09-13 Rev 3: Complete revamp. Replaced the (2) 1A/5V VREGs for (1) 5A/5V VREG
    [robotic_arm_arduino_uno_shield_smd.brd, robotic_arm_arduino_uno_shield_smd.sch]
2017-09-13 Rev 3: Adjusted placement of textual elements
    [robotic_arm_arduino_uno_shield_smd.brd, robotic_arm_arduino_uno_shield_smd.sch]
2017-09-14 Updated some of the devices with appropriate ATTRIBUTES
    [robotic_arm_arduino_uno_shield_smd.brd, robotic_arm_arduino_uno_shield_smd.sch]
2017-09-14 Changed potentiometer because it had the wrong DISTLINK
    [robotic_arm_arduino_uno_shield_smd.sch]
2018-04-08 Add gitignore. Rename robotic arm schematic to be the new version
    [robotic_arm_arduino_uno_shield_smd_new.brd, robotic_arm_arduino_uno_shield_smd_new.sch]
2018-04-08 Add ECE196 board - which was a previous revision.
    [robotic_arm_arduino_uno_shield_ece196.brd, robotic_arm_arduino_uno_shield_ece196.sch, robotic_arm_arduino_uno_shield_new.brd, robotic_arm_arduino_uno_shield_new.sch]
2018-04-08 Fix inconsistency
    [robotic_arm_arduino_uno_shield_ece196.brd]
2018-04-08 Rev 3: ECE 196 board. Add PiB logo.
    [robotic_arm_arduino_uno_shield_ece196.brd]
2018-04-09 Updated ECE196 board. Made a bit smaller
    [robotic_arm_arduino_uno_shield_ece196.brd, robotic_arm_arduino_uno_shield_ece196.sch]
2018-04-09 Small corrections.
    [robotic_arm_arduino_uno_shield_ece196.brd, robotic_arm_arduino_uno_shield_ece196.sch]
2018-04-09 Rev 4: Fixed error not connecting analog pins. Ready for fab.
    [robotic_arm_arduino_uno_shield_ece196.brd, robotic_arm_arduino_uno_shield_ece196.sch]
2018-04-09 Updated attributes of tactile button
    [robotic_arm_arduino_uno_shield_ece196.brd, robotic_arm_arduino_uno_shield_ece196.sch]
2018-07-06 everything except representation
    [BaseServoMount.SLDPRT, BaseServoMountAssem1.SLDASM, BaseV4Part1.SLDPRT, BaseV4Part1.STL, GripperAssemV1.SLDASM, GripperHeadV4Part5.SLDPRT, GripperHeadV4Part5.STL, GripperHeadV5Part5.SLDPRT]
2018-09-04 Rev 5: Add 1000uF capacitors for potential performance boost by reducing any ripple. Add tons of vias by voltage regulators to help with heat dissipation. Update all components to newest libraries.
    [robotic_arm_arduino_uno_shield_ece196.brd, robotic_arm_arduino_uno_shield_ece196.sch]
2018-09-04 P3 part list updated
    [robotic_arm_arduino_uno_shield_ece196.csv, robotic_arm_arduino_uno_shield_ece196_partList_new.csv, robotic_arm_arduino_uno_shield_ece196_partList_new_fall18.xlsx]
2018-09-05 new and better part list
    [robotic_arm_arduino_uno_shield_ece196_partList_new.csv, robotic_arm_arduino_uno_shield_ece196_partList_new_fall18.xlsx]
